i2cy/LockingLock/docs/CAD/assets/BOTTOM.png

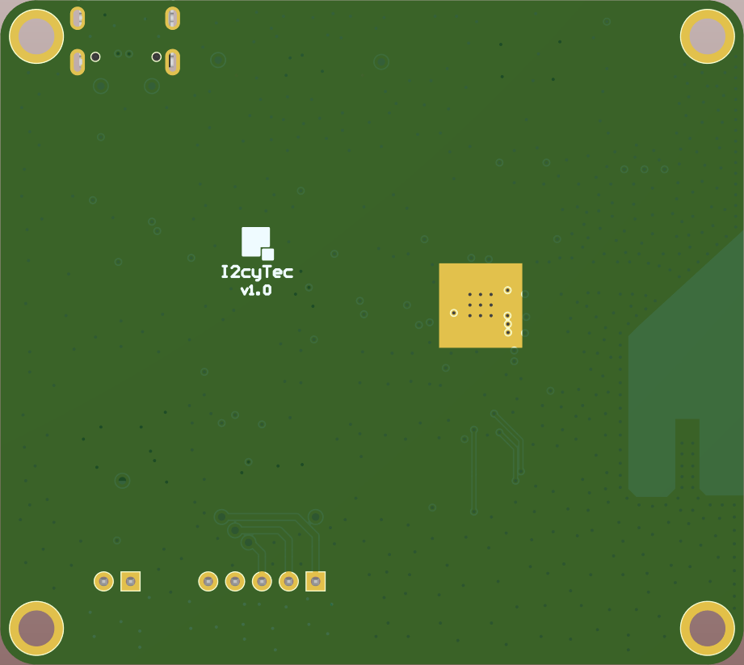
docs/CAD/assets/BOTTOM.png
