i2cy/LockingLock/docs/CAD/assets/TOP.png

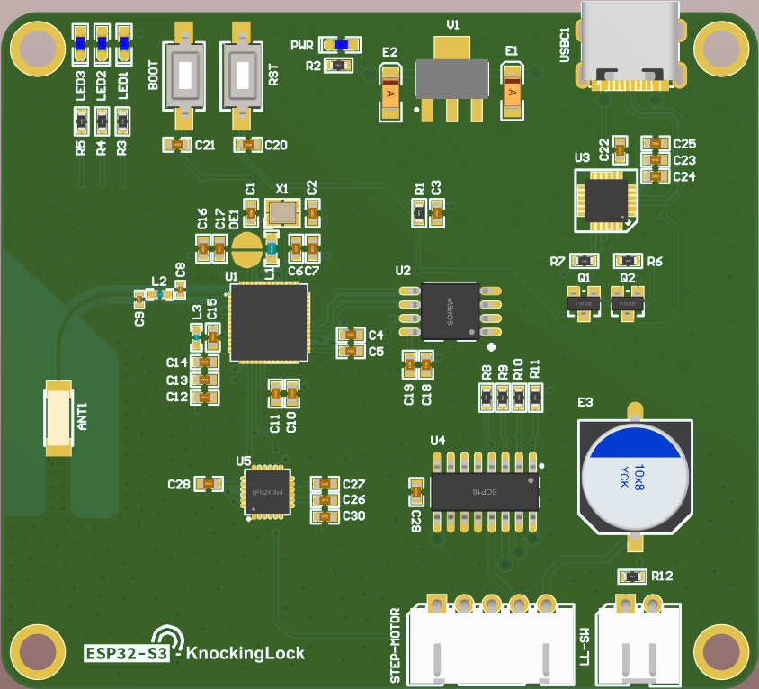
docs/CAD/assets/TOP.png
