i2cy/LockingLock/docs/pics/hardware.png

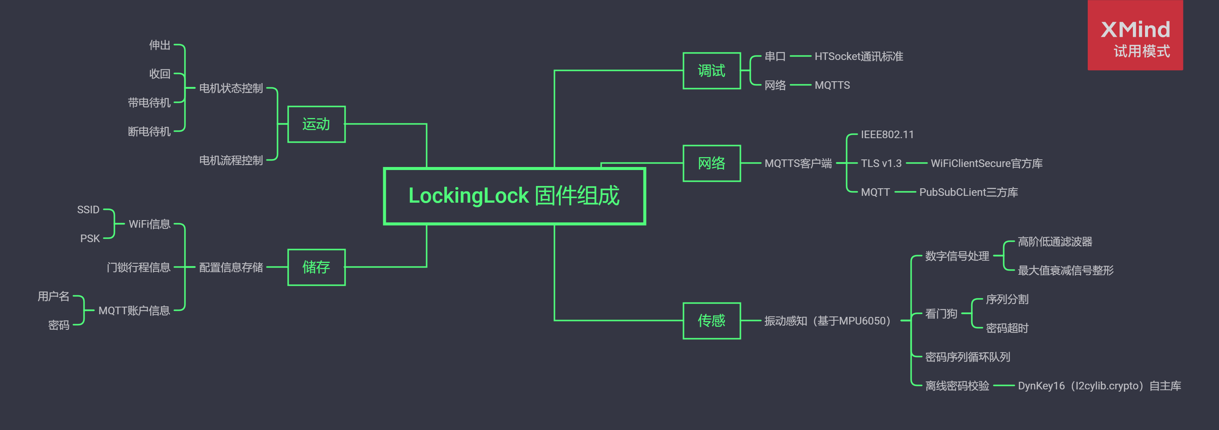
docs/pics/hardware.png
