i2cy/LockingLock/docs/pics/motor_module.jpg

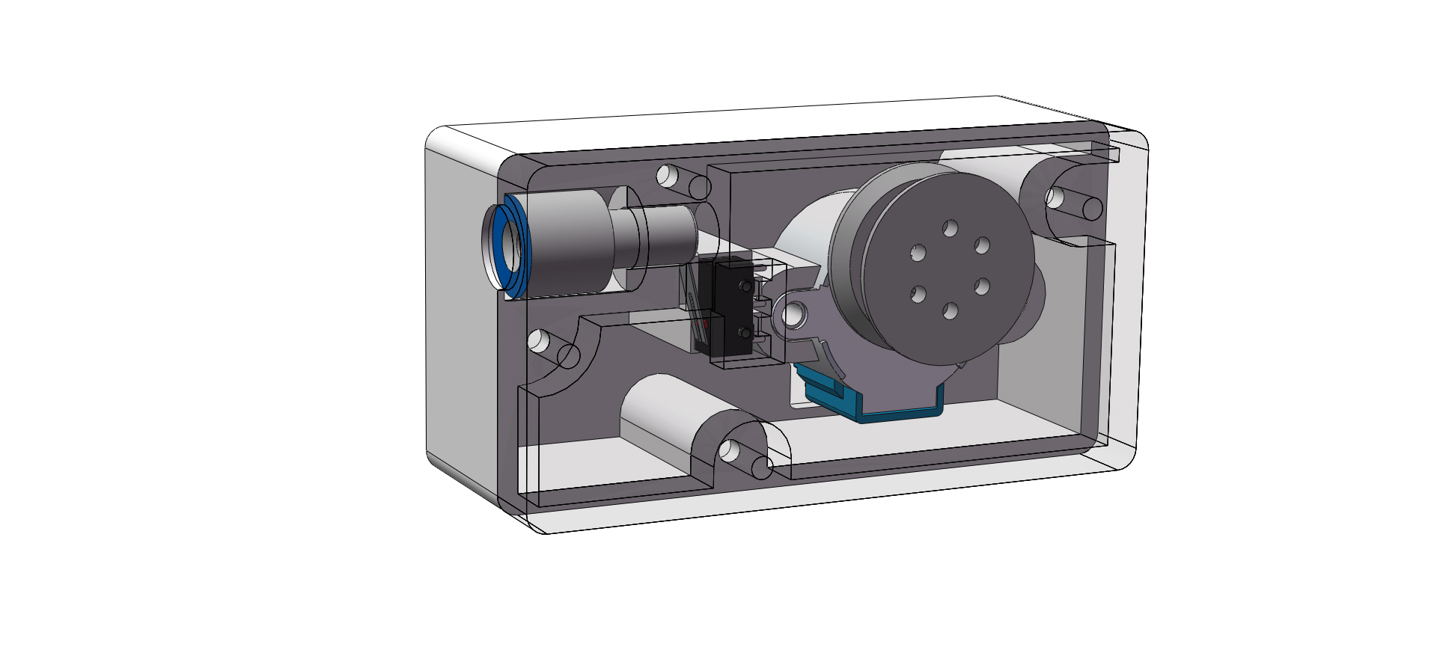
docs/pics/motor_module.jpg
