i2cy/LockingLock/docs/pics/pcb_module.JPG

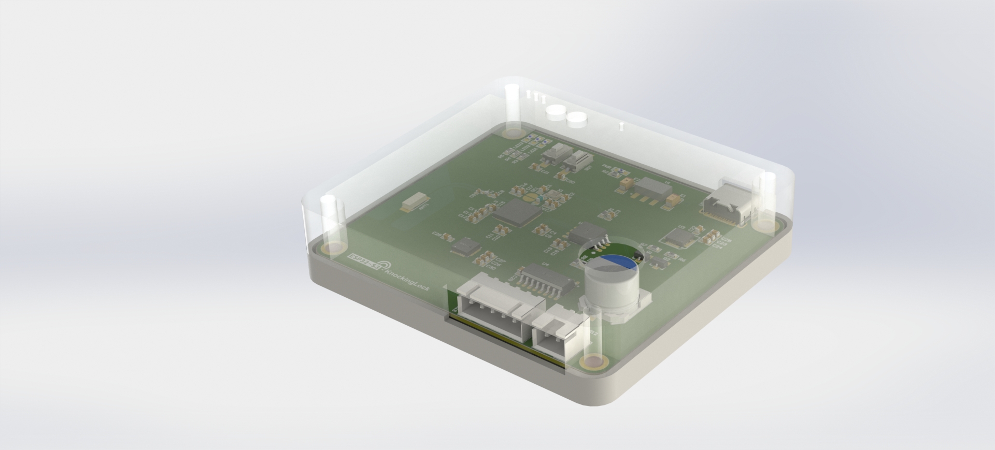
docs/pics/pcb_module.JPG
