i2cy/LockingLock/docs/CAD/一体化卷线轴装配体.SLDASM

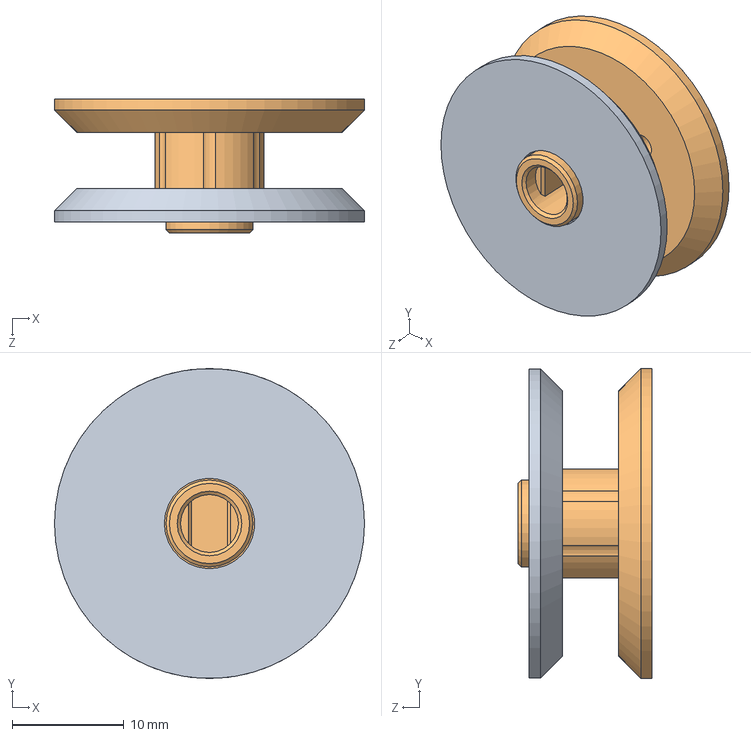
[picture p6: CAD file, 2022-10-19]
docs/CAD/一体化卷线轴装配体.SLDASM
27.8 x 27.8 x 12.0 mm
一体化卷线轴挡线盘
一体化卷线轴
