i2cy/LockingLock/docs/CAD/锁芯装配体.SLDASM

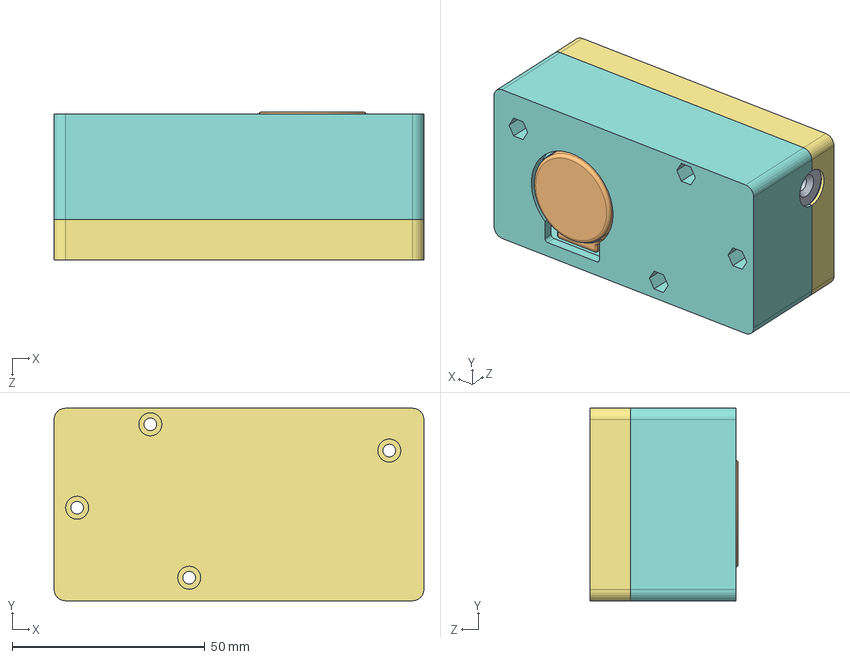
[picture p7: CAD file, 2022-10-19]
docs/CAD/锁芯装配体.SLDASM
96.0 x 50.0 x 38.5 mm
线轴限位活塞
电机
一体化卷线轴挡线盘
一体化卷线轴
微动开关底座
微动开关弹片
锁芯外壳（下）
锁芯外壳（上）
