i2cy/LockingLock/docs/CAD/驱动轴装配体大扭矩版.SLDASM

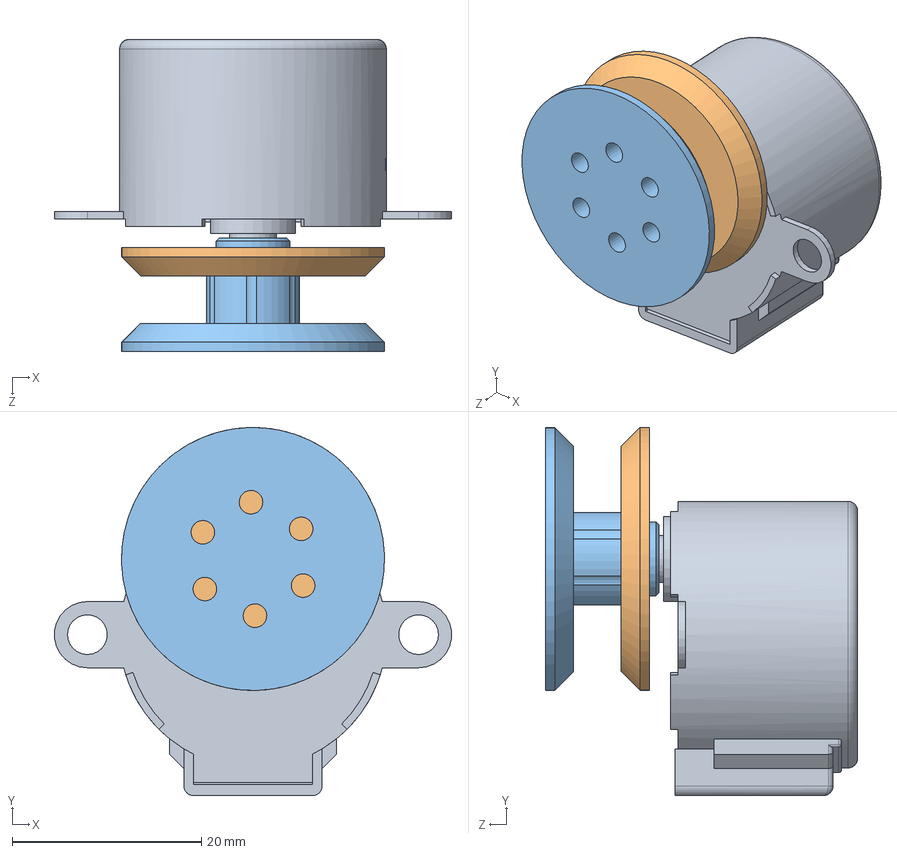
[picture p8: CAD file, 2022-10-19]
docs/CAD/驱动轴装配体大扭矩版.SLDASM
41.9 x 38.9 x 33.0 mm
电机
一体化卷线轴挡线盘
一体化卷线轴
