i2cy/LockingLock/docs/CAD/微动开关装配体.SLDASM

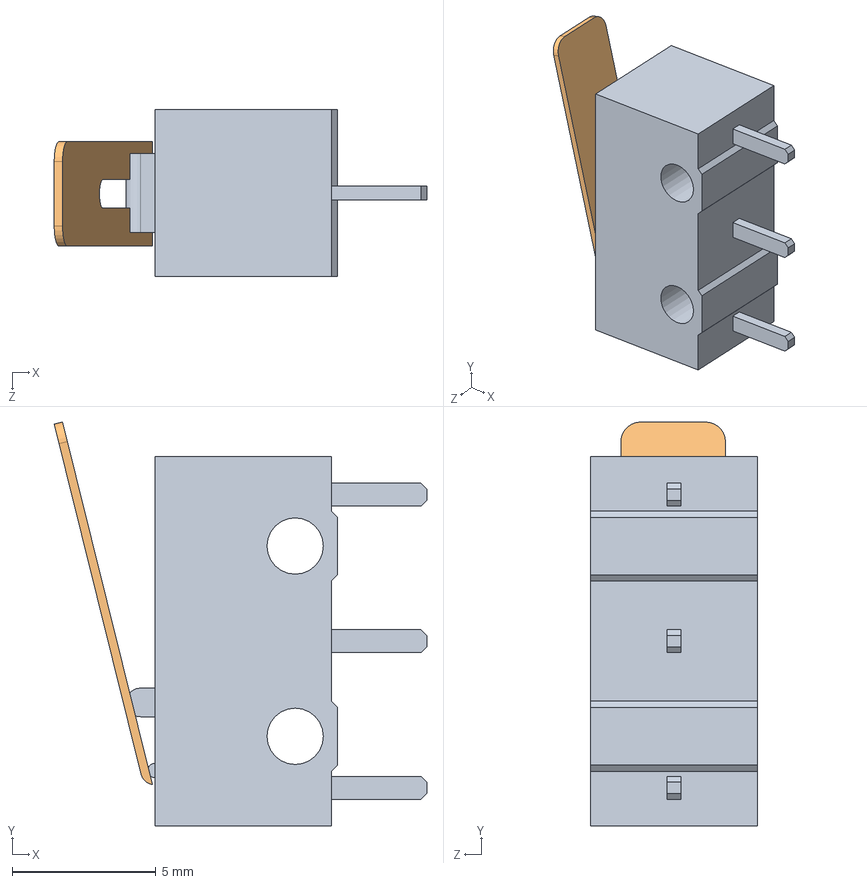
[picture p9: CAD file, 2022-10-19]
docs/CAD/微动开关装配体.SLDASM
13.0 x 14.1 x 5.80 mm
微动开关底座
微动开关弹片
