i2cy/LockingLock/docs/CAD/总装配体.SLDASM

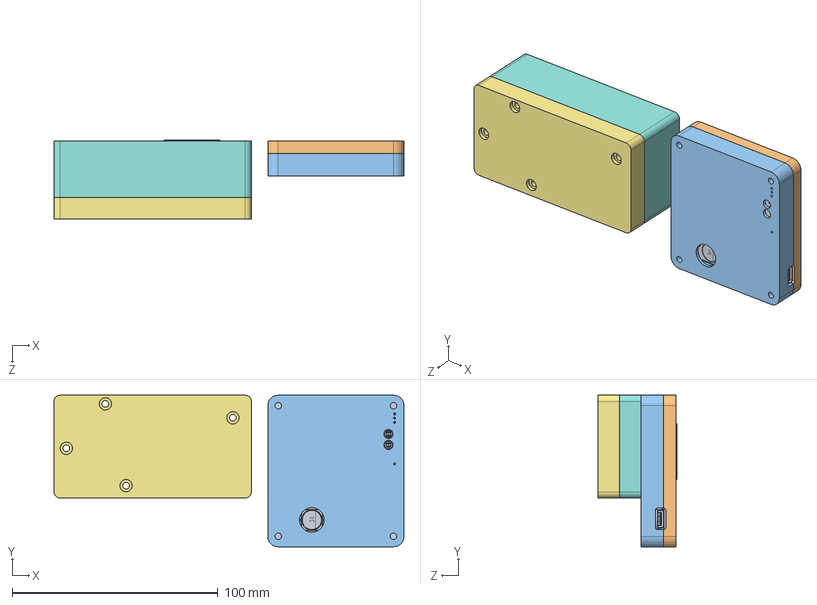
[picture p10: CAD file, 2022-10-19]
docs/CAD/总装配体.SLDASM
170.2 x 73.7 x 38.5 mm
线轴限位活塞
电机
一体化卷线轴挡线盘
一体化卷线轴
微动开关底座
微动开关弹片
锁芯外壳（下）
锁芯外壳（上）
主控板
主控外壳（下）
主控外壳（上）
