i2cy/LockingLock/docs/CAD/主控外壳装配体.SLDASM

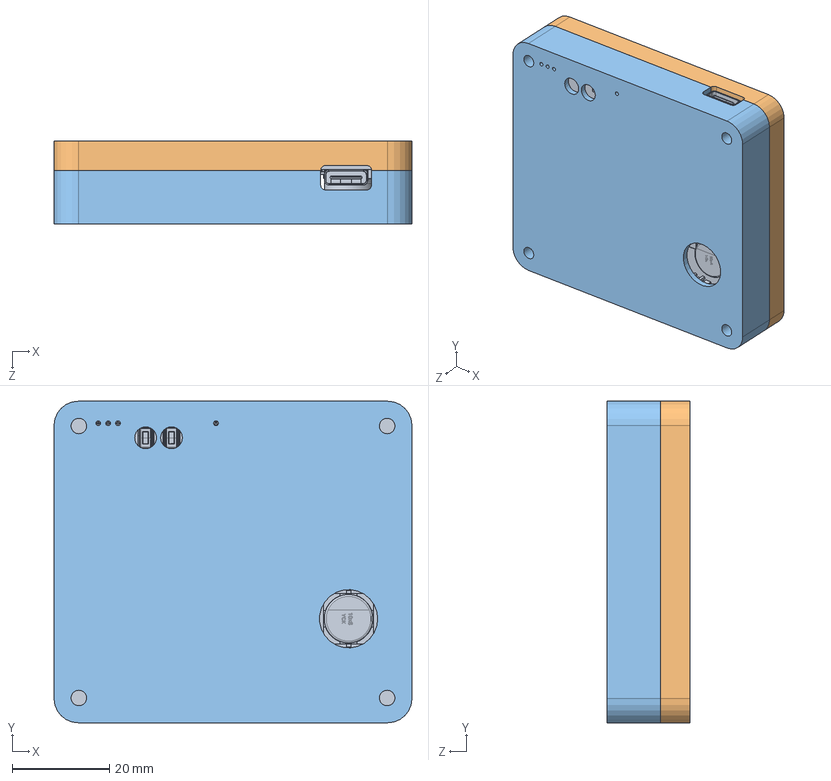
[picture p11: CAD file, 2022-10-19]
docs/CAD/主控外壳装配体.SLDASM
73.7 x 66.2 x 17.0 mm
主控板
主控外壳（下）
主控外壳（上）
