i2cy/LockingLock/docs/CAD/驱动轴装配体.SLDASM

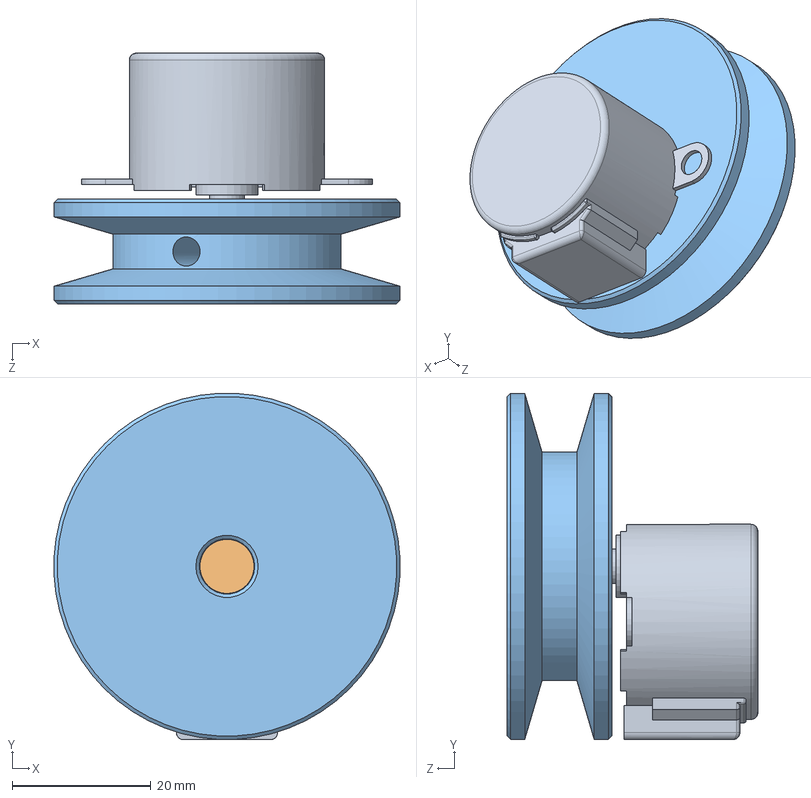
[picture p12: CAD file, 2022-10-19]
docs/CAD/驱动轴装配体.SLDASM
49.9 x 50.0 x 36.2 mm
电机
轴套
工形线轴
