i2cy/LockingLock/docs/CAD/release/主控外壳装配体/主控外壳装配体 - 主控外壳（下）-1.STL

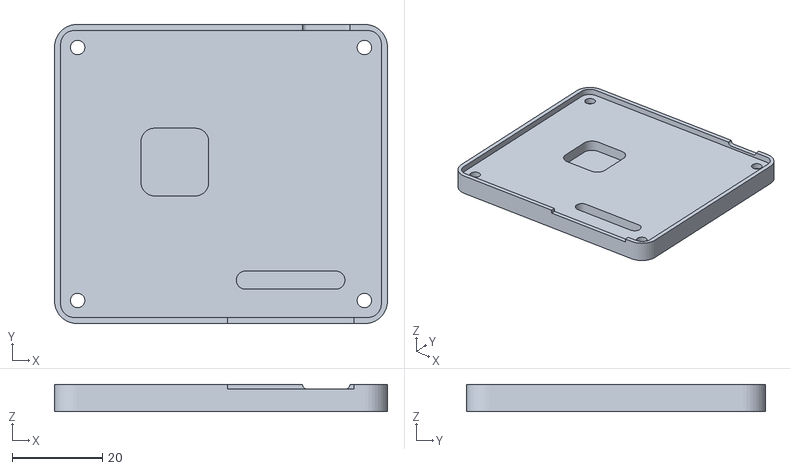
[picture p13: CAD file, 2022-10-19]
docs/CAD/release/主控外壳装配体/主控外壳装配体 - 主控外壳（下）-1.STL
73.7 x 66.2 x 6.00
