i2cy/LockingLock/docs/CAD/线轴限位活塞.SLDPRT

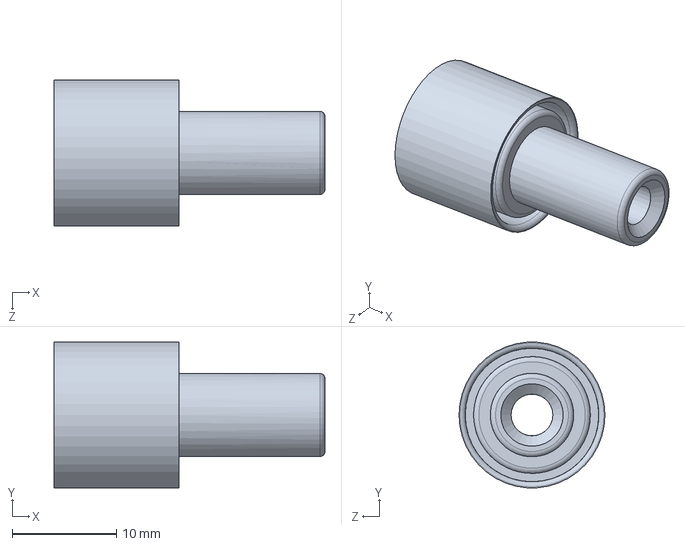
[picture p15: CAD file, 2022-10-19]
docs/CAD/线轴限位活塞.SLDPRT
26.0 x 14.0 x 14.0 mm
