i2cy/LockingLock/docs/CAD/release/主控外壳装配体/主控外壳装配体 - 主控外壳（上）-1.STL

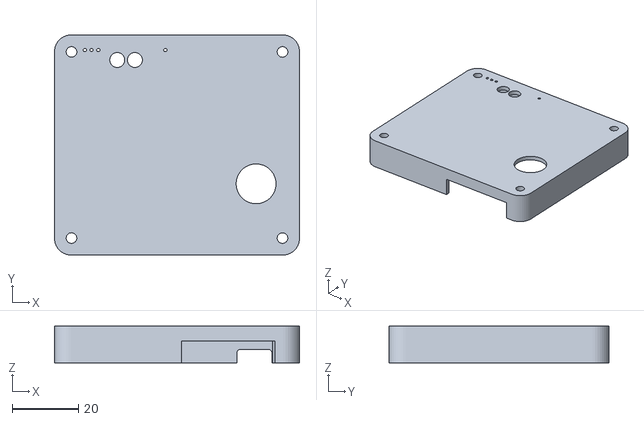
[picture p16: CAD file, 2022-10-19]
docs/CAD/release/主控外壳装配体/主控外壳装配体 - 主控外壳（上）-1.STL
73.7 x 66.2 x 11.0
