i2cy/LockingLock/docs/CAD/release/锁芯装配体/锁芯装配体 - 微动开关装配体-1 微动开关弹片-1.STL

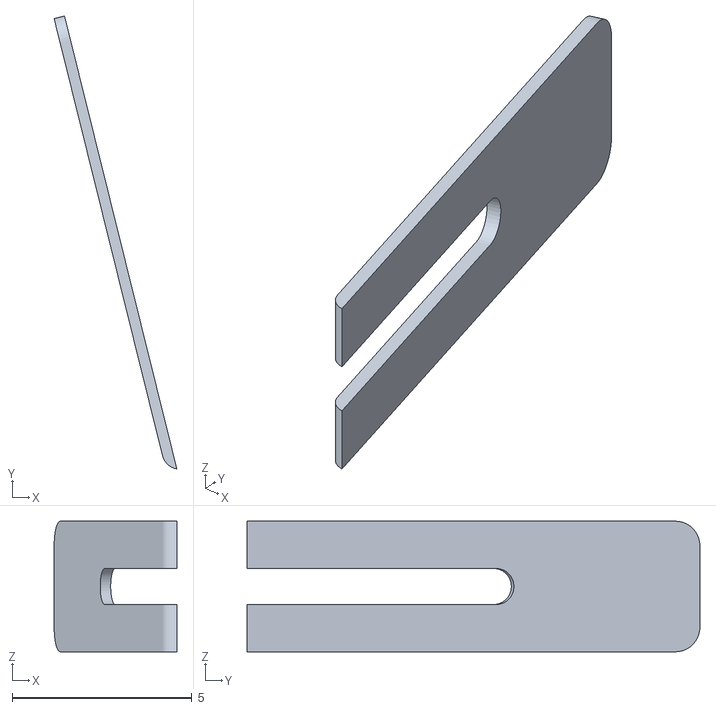
[picture p17: CAD file, 2022-10-19]
docs/CAD/release/锁芯装配体/锁芯装配体 - 微动开关装配体-1 微动开关弹片-1.STL
3.42 x 12.6 x 3.64
