i2cy/LockingLock/docs/CAD/release/主控外壳装配体/主控外壳装配体 - 主控板-1.STL

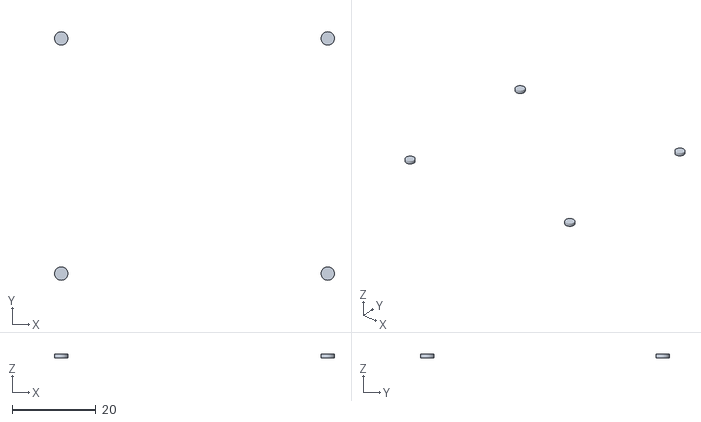
[picture p18: CAD file, 2022-10-19]
docs/CAD/release/主控外壳装配体/主控外壳装配体 - 主控板-1.STL
66.7 x 59.2 x 1.00
