i2cy/LockingLock/docs/CAD/主控外壳（下）.SLDPRT

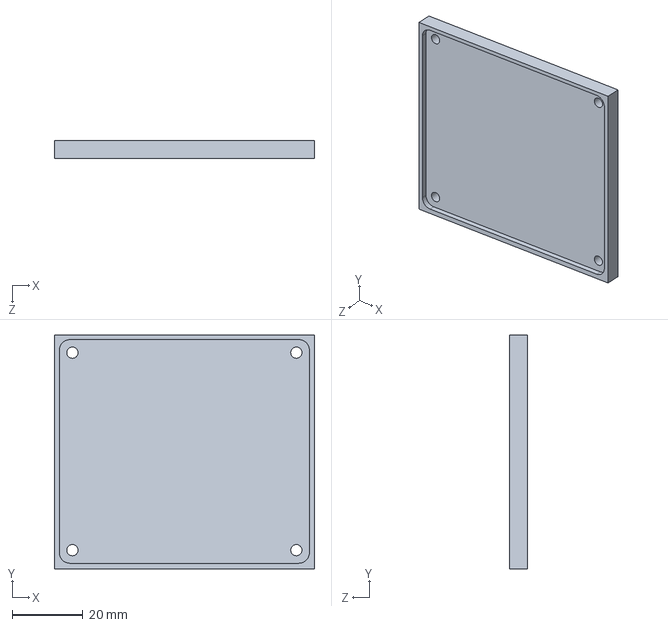
[picture p19: CAD file, 2022-10-19]
docs/CAD/主控外壳（下）.SLDPRT
73.7 x 66.2 x 5.00 mm
