i2cy/LockingLock/docs/CAD/release/锁芯装配体/锁芯装配体 - 锁芯外壳（下）-1.STL

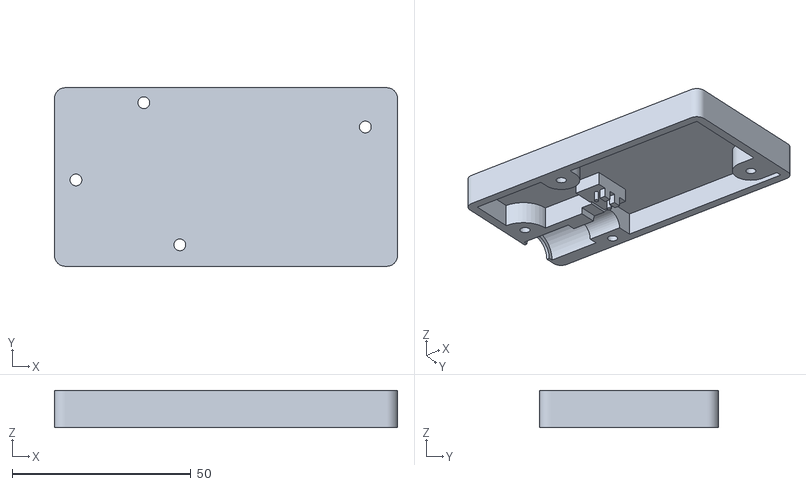
[picture p20: CAD file, 2022-10-19]
docs/CAD/release/锁芯装配体/锁芯装配体 - 锁芯外壳（下）-1.STL
96.0 x 50.0 x 10.5
