i2cy/LockingLock/docs/CAD/release/锁芯装配体/锁芯装配体 - 驱动轴装配体大扭矩版-1 电机-1.STL

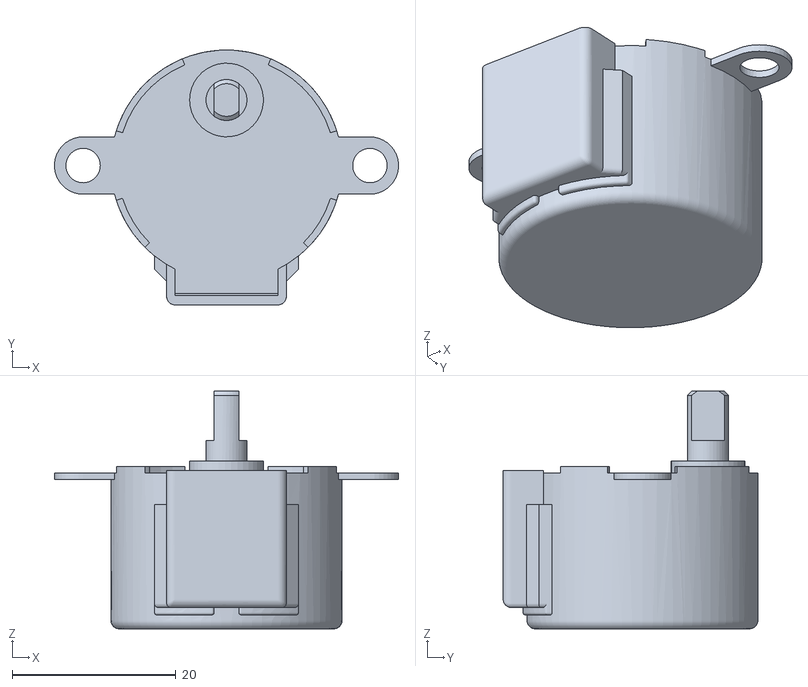
[picture p21: CAD file, 2022-10-19]
docs/CAD/release/锁芯装配体/锁芯装配体 - 驱动轴装配体大扭矩版-1 电机-1.STL
42.0 x 31.1 x 29.0
