i2cy/LockingLock/docs/CAD/锁芯外壳（上）.SLDPRT

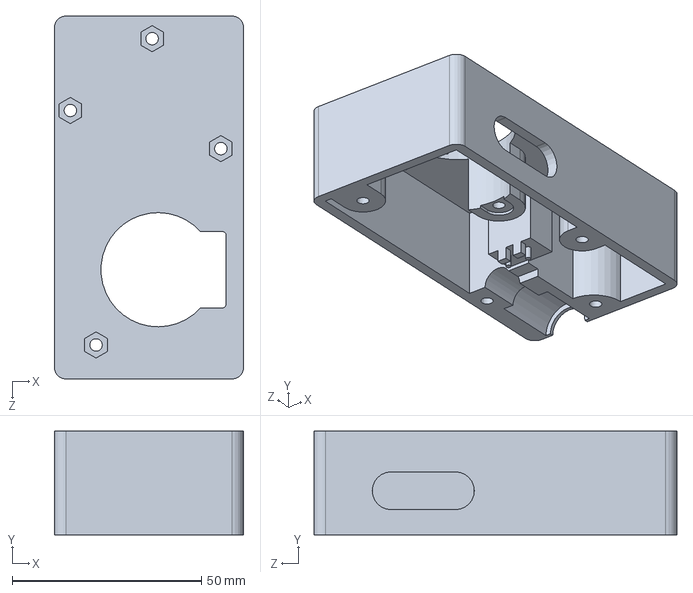
[picture p22: CAD file, 2022-10-19]
docs/CAD/锁芯外壳（上）.SLDPRT
50.0 x 27.5 x 96.0 mm
