i2cy/LockingLock/docs/CAD/工形线轴.SLDPRT

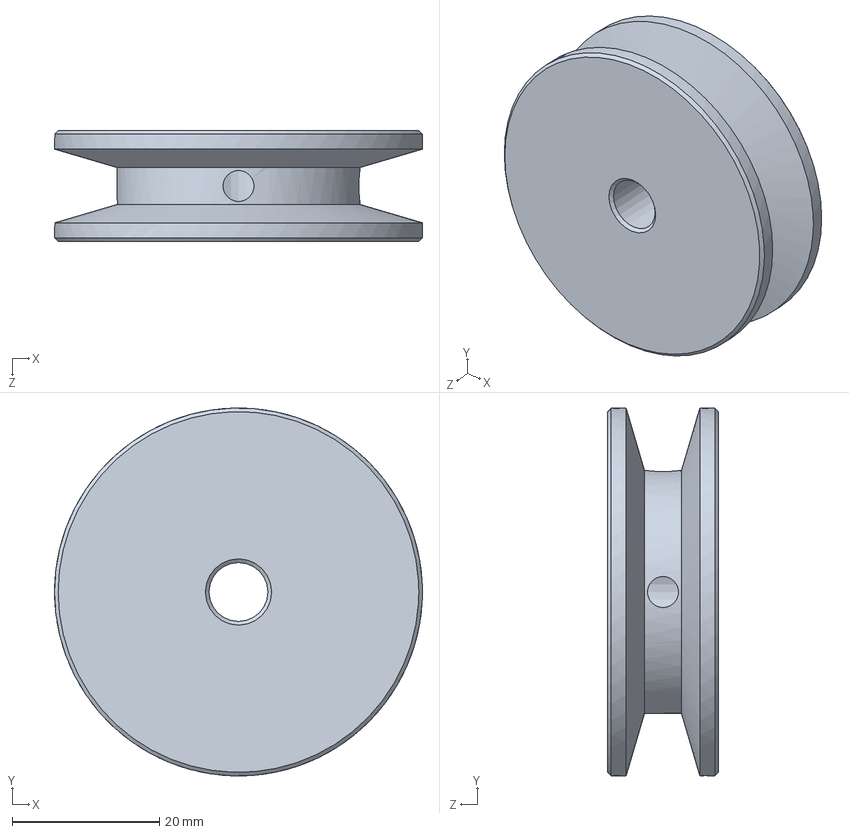
[picture p23: CAD file, 2022-10-19]
docs/CAD/工形线轴.SLDPRT
50.0 x 50.0 x 15.1 mm
