i2cy/LockingLock/docs/CAD/锁芯外壳切割.SLDPRT

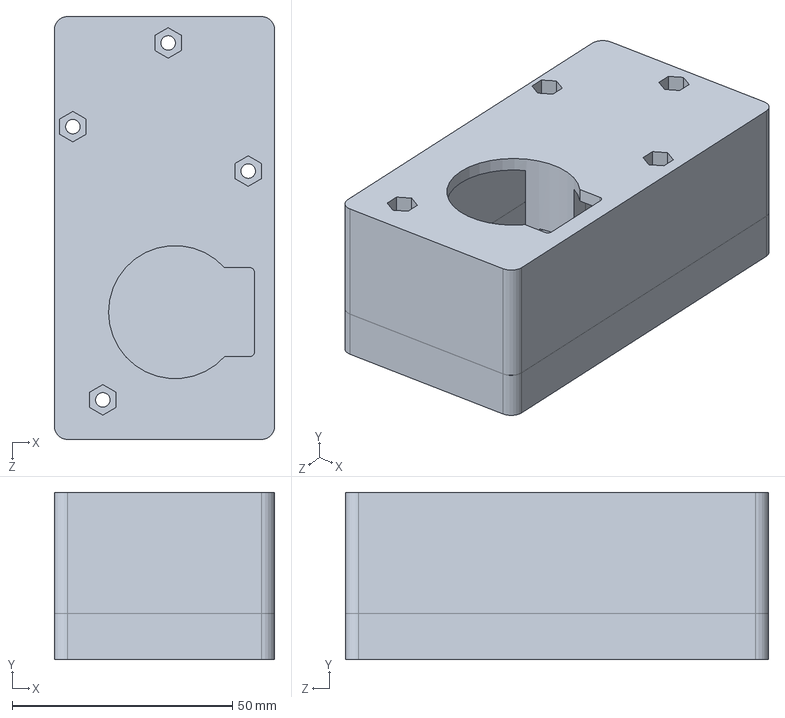
[picture p24: CAD file, 2022-10-19]
docs/CAD/锁芯外壳切割.SLDPRT
50.0 x 38.0 x 96.0 mm
