i2cy/LockingLock/docs/CAD/轴套.SLDPRT

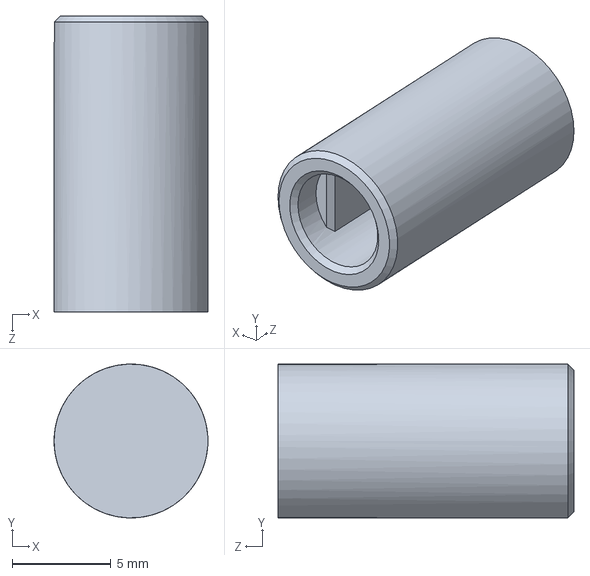
[picture p25: CAD file, 2022-10-19]
docs/CAD/轴套.SLDPRT
7.80 x 7.79 x 15.0 mm
