i2cy/LockingLock/docs/CAD/release/锁芯装配体/锁芯装配体 - 驱动轴装配体大扭矩版-1 一体化卷线轴装配体-1 一体化卷线轴-1.STL

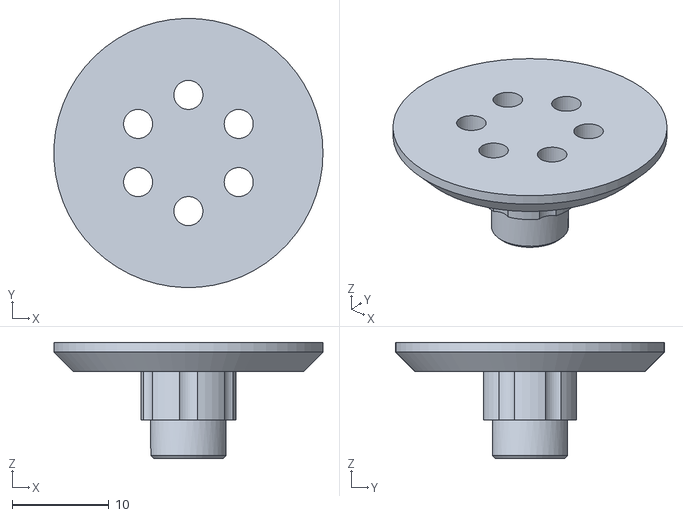
[picture p26: CAD file, 2022-10-19]
docs/CAD/release/锁芯装配体/锁芯装配体 - 驱动轴装配体大扭矩版-1 一体化卷线轴装配体-1 一体化卷线轴-1.STL
27.8 x 27.8 x 12.0
