i2cy/LockingLock/docs/CAD/release/锁芯装配体/锁芯装配体 - 微动开关装配体-1 微动开关底座-1.STL

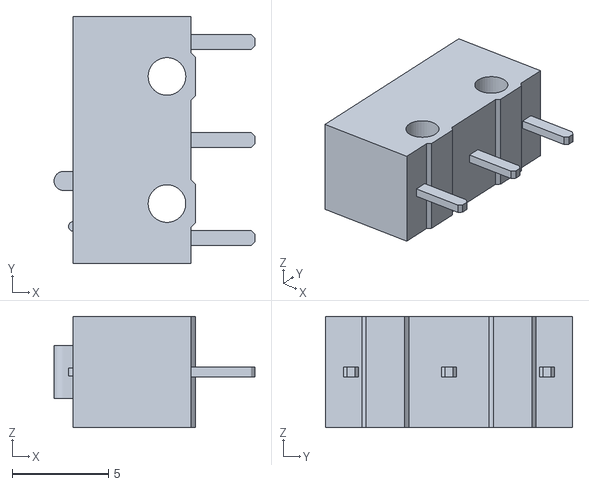
[picture p27: CAD file, 2022-10-19]
docs/CAD/release/锁芯装配体/锁芯装配体 - 微动开关装配体-1 微动开关底座-1.STL
10.5 x 12.9 x 5.80
