i2cy/LockingLock/docs/CAD/微动开关弹片.SLDPRT

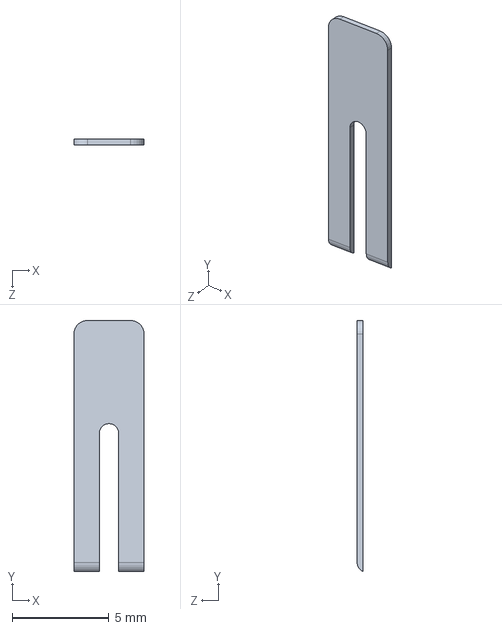
[picture p28: CAD file, 2022-10-19]
docs/CAD/微动开关弹片.SLDPRT
3.64 x 13.0 x 0.3 mm
