i2cy/LockingLock/docs/CAD/简化主控板.SLDPRT

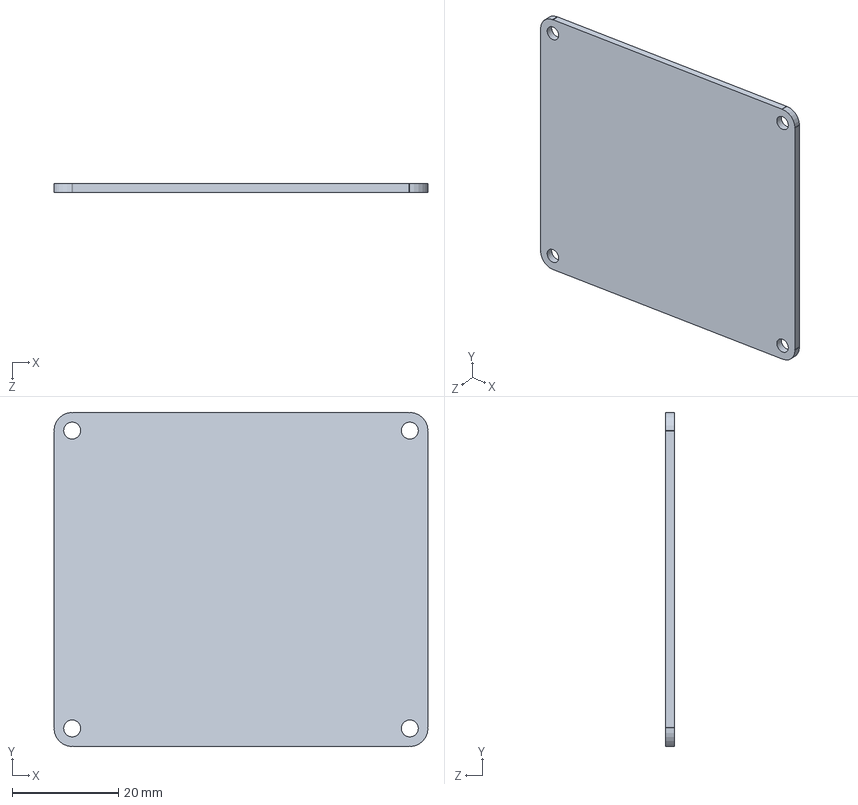
[picture p29: CAD file, 2022-10-19]
docs/CAD/简化主控板.SLDPRT
70.3 x 62.8 x 1.60 mm
