i2cy/LockingLock/docs/CAD/锁芯.SLDPRT

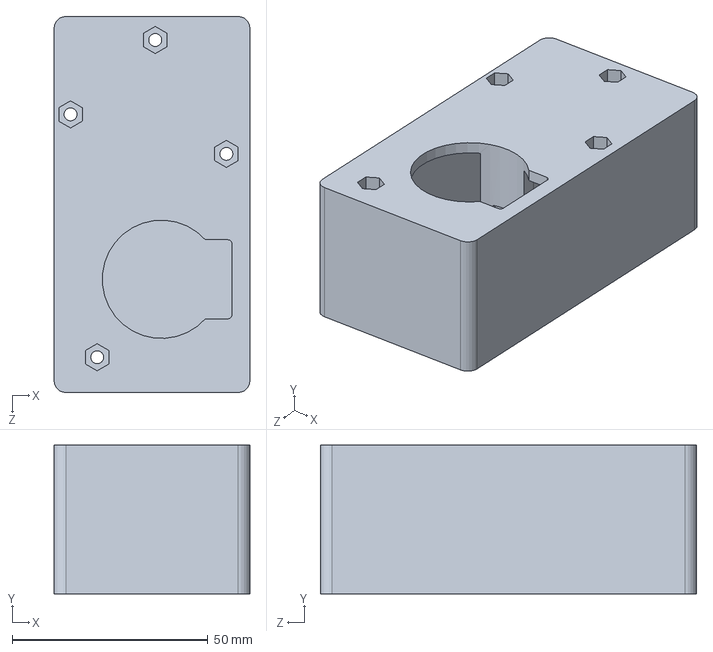
[picture p30: CAD file, 2022-10-19]
docs/CAD/锁芯.SLDPRT
50.0 x 38.0 x 96.0 mm
