i2cy/LockingLock/(list of files, cad)

Other CAD files:
docs/CAD/release/锁芯装配体/锁芯装配体 - 锁芯外壳（下）-1 - 驱动轴装配体大扭矩版-1 一体化卷线轴装配体-1 一体化卷线轴挡线盘-1.STL
docs/CAD/主控外壳（上）.SLDPRT
docs/CAD/release/锁芯装配体/锁芯装配体 - 锁芯外壳（下）-1 - 主控板-1.STL
docs/CAD/release/锁芯装配体/锁芯装配体 - 锁芯外壳（下）-1 - 锁芯外壳（下）-1.STL
docs/CAD/release/锁芯装配体/锁芯装配体 - 锁芯外壳（下）-1 - 锁芯外壳（上）-1.STL
docs/CAD/release/锁芯装配体/锁芯装配体 - 锁芯外壳（下）-1 - 驱动轴装配体大扭矩版-1 电机-1.STL
docs/CAD/release/锁芯装配体/锁芯装配体 - 线轴限位活塞-1.STL
docs/CAD/release/锁芯装配体/锁芯装配体 - 锁芯外壳（上）-1.STL
docs/CAD/锁芯外壳（下）.SLDPRT
docs/CAD/release/锁芯装配体/锁芯装配体 - 锁芯外壳（下）-1 - 微动开关装配体-1 微动开关弹片-1.STL
docs/CAD/一体化卷线轴挡线盘.SLDPRT
docs/CAD/release/锁芯装配体/锁芯装配体 - 主控板-1.STL
docs/CAD/release/锁芯装配体/锁芯装配体 - 锁芯外壳（下）-1 - 微动开关装配体-1 微动开关底座-1.STL
docs/CAD/release/锁芯装配体/锁芯装配体 - 锁芯外壳（下）-1 - 线轴限位活塞-1.STL
docs/CAD/一体化卷线轴.SLDPRT
docs/CAD/电机.SLDPRT
docs/CAD/微动开关底座.SLDPRT
