i2cy/LockingLock/(list of files, drawings)

Other design files:
docs/ECAD/core.SchDoc
docs/ECAD/ESP32-S3-StandardSystem.PrjPCB
docs/ECAD/motor&sensor.SchDoc
docs/ECAD/utils.SchDoc
