i2cy/LockingLock/src/modules/kernel.h

/***------------------------------------***
 Project: LockingLock
 Filename: kernel.h
 Author: I2cy(i2cy@outlook.com)
 Created on: 2022/8/11
***------------------------------------***/


#ifndef LOCKINGLOCK_KERNEL_H
#define LOCKINGLOCK_KERNEL_H

#endif //LOCKINGLOCK_KERNEL_H


void initKernel();
void kernelLoopCPU2(void *pvParameters);
void kernelTask();
