i2cy/LockingLock/(commit log)

2022-08-12 updated initialization part of MPU6050 with auto-calibration algorithm
2022-08-12 updated auto-calibration algorithm
2022-08-14 updated auto-calibration algorithm, created dual core task for better performance
2022-08-14 updated motor driver with sequential coding, updated veneration detect algorithm (incomplete)
2022-08-14 fixed veneration detect algorithm (incomplete)
    [kernel.cpp, mpu6050.cpp]
2022-08-17 updated MPU6050 vibrating censoring algorithm, deleted MPU6050 debugging code
    [kernel.cpp, keygen.cpp, keygen.h, motor.cpp, mpu6050.cpp, mpu6050.h]
2022-08-21 updated MPU6050 vibrating censoring algorithm, testing DynKey algorithm
    [kernel.cpp, keygen.cpp, keygen.h, led.cpp, main.cpp, mpu6050.cpp, mqtts.cpp]
2022-08-22 updated motor offset calibration sequence
2022-08-22 fixed bugs in mqtt command transmission
    [motor.cpp, mqtts.cpp, mqtts.h]
2022-08-23 finished Dynkey16, PSK based hash library, converted from Python library i2cylib
2022-08-28 added motor offset config saving function with updated Arduino core for ESP32S3
2022-10-19 updated pcb documents
    [ESP32-S3-StandardSystem.PrjPCB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]
